Yogui79/IntexPureSpa/Docs/Image/1.HomeAssistant-OFF_Screenshot.jpg

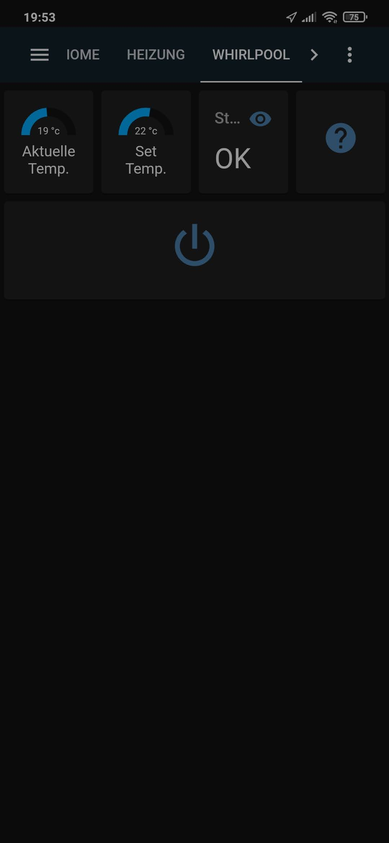
Docs/Image/1.HomeAssistant-OFF_Screenshot.jpg
