Yogui79/IntexPureSpa/Docs/Image/2.HomeAssistant-ON_Screenshot.jpg

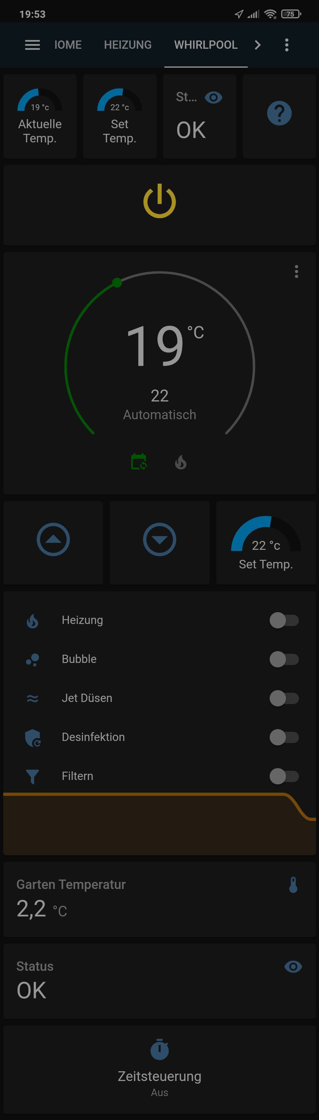
Docs/Image/2.HomeAssistant-ON_Screenshot.jpg
