Yogui79/IntexPureSpa/Docs/Image/3.HomeAssistant-Help-Infos_Screenshot.jpg

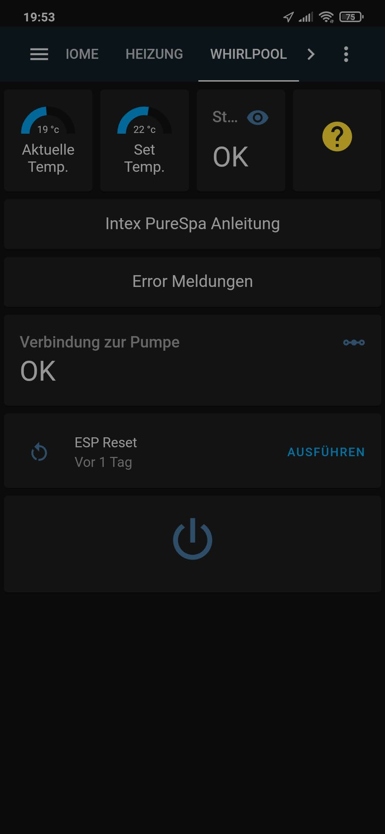
Docs/Image/3.HomeAssistant-Help-Infos_Screenshot.jpg
