Yogui79/IntexPureSpa/Docs/Image/4.HomeAssistant-Timer_Screenshot.jpg

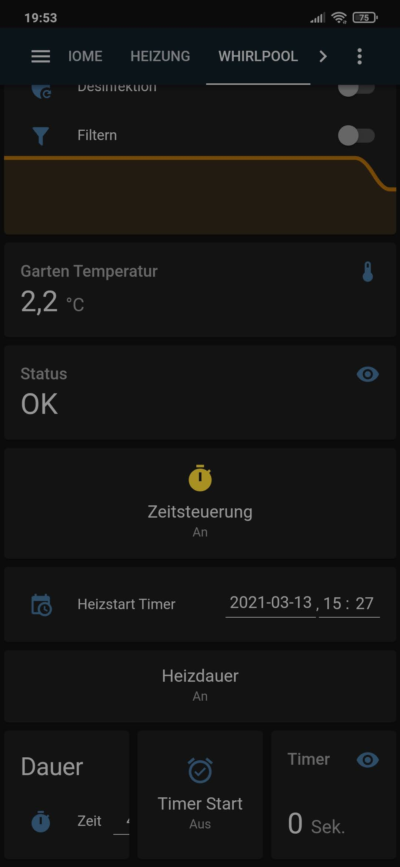
Docs/Image/4.HomeAssistant-Timer_Screenshot.jpg
