Yogui79/IntexPureSpa/Docs/Image/5.HomeAssistant-Push-notification_Screenshot.jpg

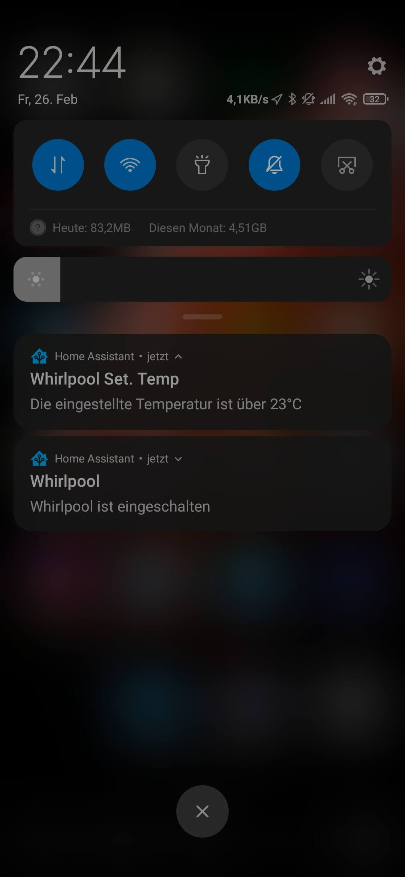
Docs/Image/5.HomeAssistant-Push-notification_Screenshot.jpg
