Yogui79/IntexPureSpa/Docs/Image/10.Jeedom-Dashboard.png

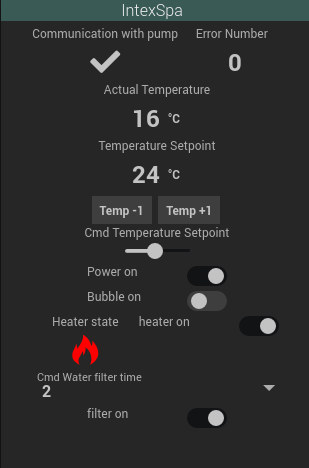
Docs/Image/10.Jeedom-Dashboard.png
