Yogui79/IntexPureSpa/Docs/Image/Board-Screenshot-IDE.PNG

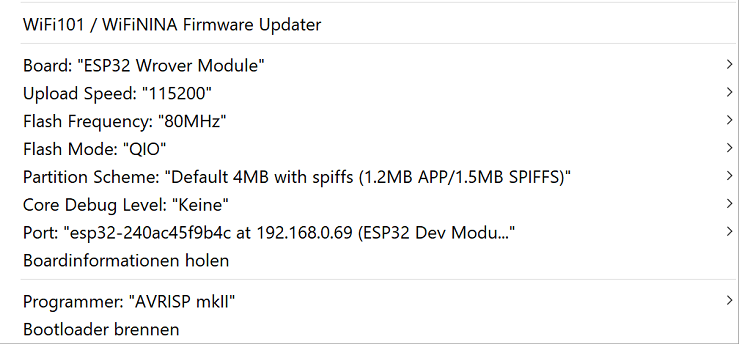
Docs/Image/Board-Screenshot-IDE.PNG
