Yogui79/IntexPureSpa/Docs/Image/Box_LC12s-ESP32_2-small.jpg

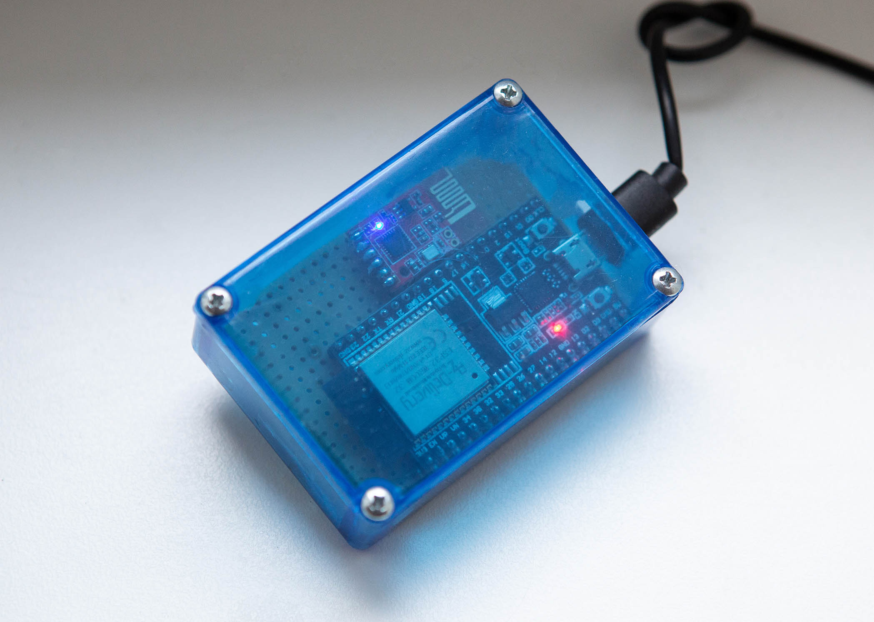
Docs/Image/Box_LC12s-ESP32_2-small.jpg
