Yogui79/IntexPureSpa/Docs/Image/Screenshot-OTA.PNG

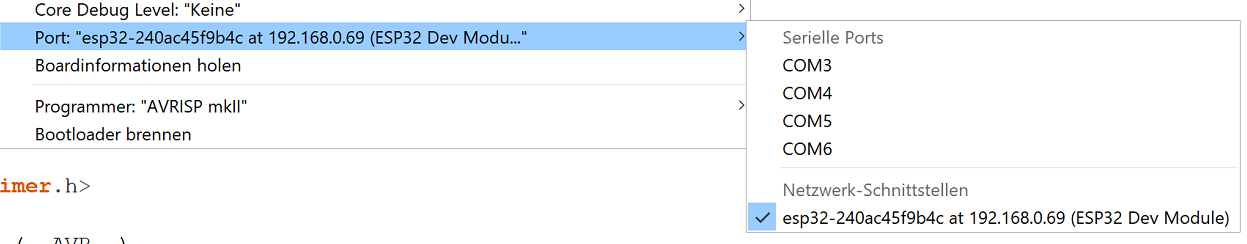
Docs/Image/Screenshot-OTA.PNG
