Yogui79/IntexPureSpa/(threads)

Thread 2 (2021-05-20):

BLE channel scanning not working

Spuri2000, 2021-05-20:
Hi
I tried to search BLE channels many times, but i cant find! The blue led always blinking.
Could you help me?

Yogui79, 2021-05-21:
Hi,
is not BLE ;)
-could you please send me the output arduino serial monitor.
- please also check the wiring be particulay attentive to the pin RX and TX pins. the pin RX from the LC12 goes on TX on the ESP an the TX from the LC12 goes on the RX from the ESP

Thread 17 (2021-07-12):

SearchNetworkID detection time

fgsam1234, 2021-07-12:
### Discussed in https://github.com/Yogui79/IntexPureSpa/discussions/16

<div type='discussions-op-text'>

<sup>Originally posted by **fgsam1234** July  9, 2021</sup>

Hi everyone,

i am running the SearchNetworkID scetch for 7 days and still have no hit. Could there be an issue or can this take so long?
I remember typically 36 hours being mentioned, which is reasonable if you consider 17^4 options for the NetworkID and 1 second per test.
It is a  28462 PureSpa.
The channel has been successfully detected with the fast blinking LED (0x4B). With commented //#define SEARCH_NETWORK_ID the LC12 LED is continuously blinking fast.
When the SearchNetworkID scetch is running with uncommented #define SEARCH_NETWORK_ID, Putty is displaying each second a new line like the one below:

Config AA 5A B9 46 07 94 00 03 00 04 00 4B 00 00 00 12 00 02
AA 5B 9F 70 07 94 00 03 00 04 00 4B 00 00 00 12 00 13

Is this normal and i have to wait for some additional days, or could something be going wrong.

@Yogui79 or @LEECHER1 could you please help me?

Kind regards,
fgsam1234

PS: A strange thing i have noticed is that the ID should be the block 5 and 6 of the hex code - i guess. - but the sketch has already send all codes from 0000 to FFFF and is now continuing from the start once again, just now the block 18 is different then before.</div>

Yogui79, 2021-07-12:
Hello

First of all you don't need to post 2 time the same post
Second as mentioned this code is delivered without warranty
I normally I answered quickly but I do it in my free time and actually I haven't free time to analyse your problem

The log you provide looks good and for me you should find the network id
As you see the code only increase the network id and wait until the spa answered if not he increase again.

Could you try the next channel or the channel before.
Please provide a complete log file.

fgsam1234, 2021-07-13:
Dear Yogui79,

Thank you for analyzing my issue. I have attached the putty log to this post.
Could you please delete the post under discussions. I just used the the button "generate issue from this post" unfortunately it just copied it to Issues and did not delete the initial post in discussions.

I have checked the neighbor channels with the  SearchNetworkID sketch with commented //#define SEARCH_NETWORK_ID. 0x4A does not produce any fast flashing of the LC12 LED. 0x4C produces a fast flashing LED, if i am close to the pump. If I am more then 2 meters away from the pump, it does not flash fast anymore.

I will now try 0x4C, just to be sure.

[putty.log](https://github.com/Yogui79/IntexPureSpa/files/6807056/putty.log)

Yogui79, 2021-07-15:
ok it means 0x4B is the right chanel
please be so close as possible from the pump for searching the network id. the remote control should also be on the pump because in this case the pump sent more that 5 signal/sec if you remove the control from the pump it send only 1/sec

fgsam1234, 2021-07-15:
Ah thanks, that is a good hint. I had the remote detatched.
The LC12 is about 0.3 meters away from the pump. So the distance should be OK.
I will try again with Channel 0x4B and the remote lying on the charging slot of the pump.

fgsam1234, 2021-07-17:
Just for my understanding:
The SearchNetworkID is trying all networkIDs from 0000 to FFFF. It is calculating the checksum from each, sends it and is waiting 1 second for the pump to answer correctly. If not positive, it tries the next.
So if block 5 an 6 of the checksum have reached FF FF all possible combinations gave been tested, correct?

Does it make sense to continue the sketch once FFFF had been reached and no networkID has been found?

fgsam1234, 2021-07-17:
Unfortunately the networkID sketch has reached FFFF for block 5 and 6.
It is still continuing to test IDs. It is currently once again at 0445.
Is it senseful to let it continue? or should I stop it and try something different? If yes, what could I try.

fgsam1234, 2021-07-19:
I was finally able to detect the correct Channel and Network ID. :-)

For that I have changed the delay in the Channelsearch sketch to 3000ms and in the networkID for sketchLastTimeReciveData to 1500ms. By that the Channel could be clearly identified and I had a hit with the networkID within roughly 8 hours.

It works now very well.

Thank you @Yogui79 for the code itself and your support.

MathieuJouslin, 2022-07-03:
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

Hello, where did you changed the delay, in the loop function or in the SetSettingsChannel function ?

Closed 2021-07-20.

Thread 18 (2021-07-19):

Question: ESP32 enclosure

w00dst0ck, 2021-07-19:
Question: Do you have a recommendation for an ESP32 enclosure?
Frage: Habt Ihr eine Empfehlung für ein ESP32 Gehäuse?

BTW: Cooles Projekt!

LEECHER1, 2021-07-19:
I bought this case from Conrad Austria.  I think it's pretty good approx. 4 €
The USB hole is selfmade. ;)

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

w00dst0ck, 2021-07-20:
Thank you for the fast reply

Closed 2021-07-20.

Thread 26 (2021-07-30):

Can't find channel

EricVdB, 2021-07-30:
Hi,

first of all this looks really awesome, it would finally allow me to integrate the SPA into our home automation using OpenHab.

But I can't get the channel search to work. It keeps on blinking steady and never blinks fast. I tried close to the SPA pump (like 5cm away), 1 meter further away, no joy.

If I understood the code well, the fast blinking should happen after you set the channel and the led goes back off, right? (DO_SET = LOW at line 134 in SearchChannel.ino)

Is there anything else i can try?

Model of the SPA = 28442 (bought in belgium)

Kind regards,
Eric

djgel, 2021-07-30:
Hi,  other  user got  a  same  problem. https://github.com/Yogui79/IntexPureSpa/discussions/7

Another   question : Using  a  ESP32 V4  dev model ?

"If I understood the code well, the fast blinking should happen after you set the channel and the led goes back off, right? (DO_SET = LOW at line 134 in SearchChannel.ino)" No, Light turn ON in setting  channel and  turn OFF because  not  rceived data.

Try use correct  board and  review  conections!

EricVdB, 2021-08-02:
Don't have a v4 board available, so I tried with a Arduino, still same result, the fast blinking never happens.
I attached my scope on the solderings and connections are good. I can decode the HEX on the serial line.

Any other ideas?

Yogui79, 2021-08-17:
hello @EricVdB
please post the serial connection logger

bendiger, 2022-04-13:
I have the same issue, I have a hot tub thats not one of the confirmed models thought. All other hardware is the same as whats listed. I have model 28441E the 6 person. I have run through the channel search about 10 times, at varying distance from the pump and from the controller. Still no fast blinks. Not sure what I'm missing, I really hope I don't have a newer model that isn't compatible with this...

bendiger, 2022-04-13:
Shoot.... so I guess my version is the 2021 model. Any hope of getting that one to work with this? Is there anything I can do to help? I do that two of them because of an RMA.

LEECHER1, 2022-04-13:
@bendig
It is easy to check the Spa version. See the screenshot.
Do you have 2021. Is WiFi default than can you use the INTEX APP.

[ https://ibb.co/LZPTPRZ](https://ibb.co/LZPTPRZ)
(Version 2020)

https://ibb.co/b6kX9Sk
(Version 2021 - with WIFI symbol in the left corner)

We haven't tried to works with the 2021, I think it's possible.

Please see how @djgel already posted that the ESP is the v4 developer version.

bertdeelman, 2022-06-09:
Hi,

I can't also retrieve the Channel and I have a 2021 model Spa. Any ideas how the solve this? And is there a way to easy check if I have the right board?

Regards,
Bert

PLCHome, 2023-03-04:
I also have a model from 2021. Before that I had the old one without WiFi. I couldn't find the channel either. However, I noticed that the small blue LED behind the display flashed faster in the old pool. I pressed the lock button to search for a channel. Then you can see the blue LED flashing behind the display. Then the LC12 also flashed at 0x2b.

Thread 38 (2021-10-31):

Home assistant: MQTT Mosquito LOG =>Look like channel change since last boot

egenu, 2021-10-31:
I followed the procedure to find the channel ID and then the Network ID, in my case 0x4C and 0xFFF
I am Fighting to setup my IntexPureSpa, control, with Home assistant: MQTT Mosquito.
I found in my MQTT logs very strange messages:
1635709111: New connection from 192.168.1.144 on port 1883.
1635709111: New client connected from 192.168.1.144 as IntexSpa (p2, c1, k15).
1635709128: New connection from 172.30.32.2 on port 1883.
1635709128: Socket error on client <unknown>, disconnecting.
1635709154: Client IntexSpa has exceeded timeout, disconnecting.
1635709248: New connection from 172.30.32.2 on port 1883.
1635709248: Socket error on client <unknown>, disconnecting.
	a
Could someone give me a hint to search in the right direction?

Yogui79, 2021-11-21:
@LEECHER1  as you use Home Assistna could you help ?

but looks like the IP dresse is wrong configurated

LEECHER1, 2021-11-21:
@egenu
Hey,

It looks the ESP32 has a bad Network (Wifi) connection.

Is the IP 192.168.1.144 the ESP32?
Please, fix the IP on the router of the ESP as static IP.

Check the WIFI Siginal with this code:
https://learn.adafruit.com/adafruit-metro-esp32-s2/wifi-test

Do you see on this link what dBM values say:
https://eyenetworks.no/en/wifi-signal-strength/

br LEECHER1

egenu, 2021-11-25:
Hi  LEECHER1 and Yogui79,

First of all I would like to say that I am amazed about the work that you have done and you have all my respect for such work!

The IP 192.168.1.144 is the ESP32, I fixed it as static IP on the router, thanks for your suggestion.
I made the Wifi test and I got a -48 dBm signal, then I believe this is not the issue.

On the other hand I retry the full procedure many times and the Channel ID has change 3x during my successive attempt , is this normal?

The last attempt that I made after applying your suggestions give me a 0x9C channel who is the first time and the Network ID program is not scanning anymore like it was the first times I launched, maybe due to Arduino updates that I had to apply?

Could someone please confirm that the SearchNetworkId.ino program is still working with latest Arduino program and library updates?

Thanks again for sharing and giving all that work to the comunity!
Egenu

Yogui79, 2021-11-26:
hello

_"On the other hand I retry the full procedure many times and the Channel ID has change 3x during my successive attempt , is this normal?_"

-> yes it's possible

please give me version you use for :+1:
Arduino ide you use
the esp32 lib you use

egenu, 2021-11-27:
Hello

Actually I have installed Arduino IDE    1.8.16
and  I use esp32 by Expressif Systems   1.0.6
EspMQTTClient              1.13.2
arduino-timer                2.3.0
ArduinoOTA                    1.0.7

Hope this was you where looking for.

Yogui79, 2021-11-27:
I haven't test with arduino ide 1.8.16 but should work
 esp32 by Expressif Systems 1.0.6 I use alsa this one.

the SearchNetworkId.ino  sketch is only to detect the network id from the LC12s from the pump and the first preoblem you speek about was a mqtt pissue.

please could you be more clear :
1 do you find the chanel ?
2 download the sketch  SearchNetworkId.ino and modifie the line uint8_t Channel =0x47; with your chanel
3 post a video from your LC12s after that

egenu, 2021-11-27:
Hello, sorry to add more confusion than wanted. Due to the fact that I didn't understood, if my issue was coming from the fact that the source of my unsuccessful attempt was coming from the :
MQTT <=> Home assistant or SPA <=> Board with the channel ID and then the Network ID found a
Then I retry many times the full operation and this is why I was surprised to see a different chanel.

To answer to your questions
1) do you find the chanel ?
-> Yes 9B & 9C
2) Edited the line uint8_t Channel =0x9B ;and download it
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

3) -> https://user-images.githubusercontent.com/73351718/143678705-afa00b44-c4f3-4772-9b33-0106038f859d.MOV

Yogui79, 2021-11-27:
look's good
now remove the // from this line #define SEARCH_NETWORK_ID
upload the sketch
start monitoring the ouput with puty and save the data in a file the search network id  can last up to 36 hours you will ahve a message when the network id is found

egenu, 2021-11-28:
Hi,

Look like my previous NETWORK_ID didn't success, even if I had a similar message at the end.
----------------------------
  Your network id is:
         0x153F
----------------------------
Then I put the "used_chanel" (0x9B) and "used_network" (0x153F) on my "PureSpa Sofware" with the MQTT and WIFI settings
and sudainly works like a charm.

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

Many thanks to both.

egenu, 2021-11-28:
Still an issue :(
after removing the PC and using a wall mount plug the board is blinking like before, but I am unable to get control / communication with Homeassistant, but the fixe IP on the board is answering his the IP 192.168.1.144 (ping)
what did I do wrong!
Cheers

LEECHER1, 2021-11-28:
Is the communication with ESP32 to Pump and Controller okay?
Maybe the channel has changed. Is possible from time to time. Wait a little bit ~10min

Or is only the communication with ESP32 to Home Assistant not okay?

egenu, 2021-11-28:
I have trouble to understand, how to diagnose the communication with ESP32 to Pump and Controller? Is only with the blinking led that you are able know? How to access the serial communication when the ESP32 is not anymore USB connected to my PC, with OTA Arduino IDE complains that the:
 "Serial Monitor is not supported on network ports such as 192.168.1.144 for the ESP32 Dev Module i this release"

From the Home Assistant Mosquito MQTT broker log I believe it works:
I see the following, and I assume this parts works, but as it do not update he is in TIMEOUT situation:

1638114518: New connection from 192.168.1.144 on port 1883.
1638114518: New client connected from 192.168.1.144 as IntexSpa (p2, c1, k15).
...
1638114978: Client IntexSpa has exceeded timeout, disconnecting.

Yogui79, 2021-11-30:
` have trouble to understand, how to diagnose the communication with ESP32 to Pump and Controller? Is only with the blinking led that you are able know? ` yes only over the blinking from the blue led it should be very fast
yo have no way to diagnose over ota

egenu, 2021-12-04:
Hello good news,

I had to reset completely my SPA. the controller "tablet" discharging it completely .
I left the SPA without power for 24 hours to.
After this "RESET", I just try the connectivity using a wall mount plug for the ESP32 board.
He is blinking like before, and everything start working inside home assistant after 10 minutes like you said!
Inside the MQTT logs I saw the INTEXSPA connectivity and doesn't timeout anymore.
A big thanks to both and if you have an By me a Beer or something else I would be happy to contribute.

Closed 2021-12-04.

Thread 39 (2021-11-18):

Spa Programm not working

HansEhls, 2021-11-18:
Hi there,
I have an Intex Pure Spa 28462 whirlpool and am trying to get the GitHub project up and running.

Hardware built wasn't that difficult.
Connected, I also found the channel, then also the network address.

Now I have loaded the spa program and I can't get any further because unfortunately I have no knowledge of programming.

The program logs on to the network and also to the MQTT, then some values   (probably the different statuses) are communicated wildly between the pump and the program. Then it breaks off and looks for a new channel and the whole thing starts over.
I switched on all debugs and downloaded the serial info.

Could someone help me and try to understand what the problem is?

The program also logs on to Mosquitto and sends up 2 types of messages, but none such as temperature or similar.

I also installed Home Assistant in case a handshake was required. These are the CMD messages that you see in the Mosqutitto.

It would be great if someone could help me.

Thanks in advance

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
[Serial Info.odt](https://github.com/Yogui79/IntexPureSpa/files/7565357/Serial.Info.odt)

w00dst0ck, 2021-11-18:
Have you tried to reduce the distance between the Intex and the ESP32. That fixed the problem with the lost channel for me.

HansEhls, 2021-11-18:
Hi,
thanx for the tip, but no change, even when it direct on the pump

LEECHER1, 2021-11-19:
Please try to reset the Pumpe and the distance ~1m and wait 15 min. > Not working try again.

HansEhls, 2021-11-19:
Not working. Same serial protokoll

Yogui79, 2021-11-21:
regarding the log you have distubation during communication between pump and ESP looks like you only communicate with remote control.
-> switch ESP off
->switch pump off (unplug)
->switch remoter control off
->remove remote control from the pump

-> switch on pump and reset it
-> put remote control on pump
-> be sure you dont have E81
-> switch on ESP

if not working please send a log configurate like this :

//Uncomment following line to have more debug infos
//#define DEBUG_RECIEVED_DATA
#define DEBUG_SEARCH_CHANNEL
#define DEBUG_SEND_COMMAND
#define DEBUG_PUMP_DATA
#define DEBUG_CONTROLLER_DATA
#define DEBUG_CONFIG
//#define DEBUG_MQTT
//#define DEBUG_SEND_VALUE_TO_HOME_AUTOMATION_SW

HansEhls, 2021-11-22:
Hi,

first of all thank you, that you are trying to help. no change and as I removed some debug data, the serial info is smaller now.

20:38:44.711 -> Used first command read from EEPROM 0x4B
20:38:44.711 ->  Config AA 5A B9 46 FF FF 00 00 00 04 00 4B 00 00 00 12 00 62
20:38:51.032 -> Debug Send command : 4B 00 00 00 00 00 A9 B2
20:38:52.629 -> Debug Send command : 4B 00 00 00 00 00 A9 B2
20:38:54.233 -> Debug Send command : 4B 00 00 00 00 00 A9 B2
20:38:55.462 -> Look like channel change since last boot
20:38:55.462 ->  Config AA 5A B9 46 FF FF 00 00 00 04 00 41 00 00 00 12 00 58
20:38:56.955 ->
20:38:56.955 -> Debug search Chanel : AA 5B D6 F5 FF FF 00 00 00 04 00 41 00 00 00 12 00 25  Config AA 5A B9 46 FF FF 00 00 00 04 00 42 00 00 00 12 00 59
20:38:59.432 ->
20:38:59.432 -> Debug search Chanel : AA 5B D6 F5 FF FF 00 00 00 04 00 42 00 00 00 12 00 26  Config AA 5A B9 46 FF FF 00 00 00 04 00 43 00 00 00 12 00 5A

Yogui79, 2021-11-22:
please post the debug data after the esp start
somme important information for me are her mentioned

HansEhls, 2021-11-22:
22:07:02.488 -> Ready
22:07:02.488 -> IP address: 192.168.178.201
22:07:03.579 -> Used Channel read from EEPROM 0x4B
22:07:03.579 -> Used first command read from EEPROM 0x4B
22:07:03.579 ->  Config AA 5A B9 46 FF FF 00 00 00 04 00 4B 00 00 00 12 00 62
22:07:05.078 -> AA IntexSpa/Communication with pump 1
22:07:05.882 -> 5B IntexSpa/Communication with pump 1
22:07:05.916 -> D6 IntexSpa/Communication with pump 1
22:07:05.916 -> F5 IntexSpa/Communication with pump 1
22:07:05.916 -> FF IntexSpa/Communication with pump 1
22:07:05.916 -> FF IntexSpa/Communication with pump 1
22:07:05.916 -> 00 IntexSpa/Communication with pump 1

HansEhls, 2021-11-22:
this comes up, when I reset the buttons on the board

22:48:02.289 -> ets Jun  8 2016 00:22:57
22:48:02.289 ->
22:48:02.289 -> rst:0x1 (POWERON_RESET),boot:0x3 (DOWNLOAD_BOOT(UART0/UART1/SDIO_REI_REO_V2))
22:48:02.289 -> waiting for download
22:48:03.508 -> ets Jun  8 2016 00:22:57
22:48:03.508 ->
22:48:03.508 -> rst:0x1 (POWERON_RESET),boot:0x13 (SPI_FAST_FLASH_BOOT)
22:48:03.508 -> configsip: 0, SPIWP:0xee
22:48:03.545 -> clk_drv:0x00,q_drv:0x00,d_drv:0x00,cs0_drv:0x00,hd_drv:0x00,wp_drv:0x00
22:48:03.545 -> mode:DIO, clock div:1
22:48:03.545 -> load:0x3fff0018,len:4
22:48:03.545 -> load:0x3fff001c,len:1216
22:48:03.545 -> ho 0 tail 12 room 4
22:48:03.545 -> load:0x40078000,len:10944
22:48:03.545 -> load:0x40080400,len:6388
22:48:03.545 -> entry 0x400806b4
22:48:03.789 -> E (64) psram: PSRAM ID read error: 0xffffffff
22:48:03.823 -> ----------------------------------------------------------------------------------------------------------------------
22:48:03.860 ->
22:48:03.860 ->           Intex Purespa communication sketch version 1.1.1 build on : 2021.07.31 21:27:53
22:48:03.860 ->
22:48:03.860 -> ----------------------------------------------------------------------------------------------------------------------
22:48:03.860 -> Booting
22:48:06.167 -> Ready
22:48:06.167 -> IP address: 192.168.178.201
22:48:07.291 -> Used Channel read from EEPROM 0x4B
22:48:07.291 -> Used first command read from EEPROM 0x4B
22:48:07.291 ->  Config AA 5A B9 46 FF FF 00 00 00 04 00 4B 00 00 00 12 00 62
22:48:13.661 -> Debug Send command : 4B 00 00 00 00 00 A9 B2
22:48:15.657 -> Debug Send command : 4B 00 00 00 00 00 A9 B2
22:48:19.305 -> Debug Send command : 4B 00 00 00 00 00 A9 B2
22:48:19.305 -> Look like channel change since last boot
22:48:19.305 ->  Config AA 5A B9 46 FF FF 00 00 00 04 00 41 00 00 00 12 00 58
22:48:20.813 -> 03 FF 00

HansEhls, 2021-11-22:
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
I do not know, if that is important, but in the edge down, right, there is a blue LED which is blinking fast all the time. I have no idea, if that is normal

Yogui79, 2021-11-24:
this is norma this is the conection between pum an remote control
how long did you wait after starting your ESP

HansEhls, 2021-11-24:
in the meanwhile several times over 30 min.

Yogui79, 2021-11-26:
could you poste your project ?

HansEhls, 2021-11-27:
I copied the Spa programm and did only these changes!

#define USED_NETWORK_ID    0xFFFF
#define USED_CHANNEL       **0x4B**

uncomment "//" #define _28458_28462_   // For spa model #28458 #28462 #28457(US) #28461(US)
//#define _28442_28440_   // For spa Model #28442 #28440

#if  defined (_28458_28462_) &&  defined (_28442_28440_)
  #error select only one SPA model
#endif
#if  !defined (_28458_28462_) &&  !defined (_28442_28440_)
  #error select a SPA model
#endif

/*******************************************************
*
*   S E L E C T  T H E   P R O T O C O L   Y O U   U S E
*
********************************************************/
//#define _MY_SENSORS_
#define _MQTT_

#ifdef ESP32
const char* Myssid = **"My Wlan"**;
const char* Mypassword = **"My Pass"**;
#endif

EspMQTTClient client(
  Myssid,
  Mypassword,
  "192.168.178.97",  // MQTT Broker server ip
  **"Iobroker"**,   // Can be omitted if not needed
  **"Password",**   // Can be omitted if not needed
  "IntexSpa",     // Client name that uniquely identify your device
  1883              // The MQTT port, default to 1883. this line can be omitted
);
#endif

Yogui79, 2021-11-27:
coul you olease donwload the SearchNetworkId.ino sketch
make following changes

uint8_t Channel =0x4B;
#define SEARCH_NETWORK_ID
uint16_t idtosend =0xFFFA;

en postet the serial monitor  after 10 mins

HansEhls, 2021-11-28:
I did a new channel search and found E1. Then I did a new network search and found 0x14f7. With that in the Spa Programm it did connect to the pump and also wrote the data one time into MQTT broker.

BUT:
When the ESP was connecting to the pump the controller went do E81 error. when I put off the ESP the controller searched the pump end reconnected. I did that several time, but had always the same result. I did many resets of the pump to try that again, with the same result. I think after 5 resets the ESP does not find the pump anymore.

So I starting over, reseted the pump, started the controller. After that connection seams now stable, i searched the channel, which is back to 4B. then I started the Nework scan with 0x14F0 so see, if it will find again 0x14F7. That didn´t work. So now I started the network search at 0x0000 again and wait, if it will find another network address.

Did I do something wrong?

THanks for your help. I really appreciate that.

BR
Hans

Yogui79, 2021-11-30:
Hi,
we newer se a networkid  who change but afrer switching off the pump it could be that the chanel change

HansEhls, 2021-12-01:
Update!!!
I had a connection to the controller and the pump with 0xFFFF abd 0x4B again. I played around with some own debugs to understand the programm. As I said, I am completely new to the topic programming.

Then somehow I lost the connection again and had to do a channel and network search again. I found the channel 0xA4 and with that again the netword 0x14F7.

With that, at least for the moment (the pump is in my office at the moment) I have the connection established and the programm is running.

I also have the data in MQTT, so I can start to look for the VIS in Iobroker.

Hopefully the program will work also in the future, when I setup the pool again outside in the next days.

Thanks again for your help and the effort you spend on that!

BR
Hans

Closed 2021-12-01.

Thread 40 (2021-11-19):

Network ID search

delgigio, 2021-11-19:
Good morning,
I have carefully followed the guide you have given me, I have managed to find the channels with which the whirlpool communicates which are 12 and 13.
Unfortunately, when I load the program to search for the Network ID, the blue LED does not flash as indicated, it always has the same frequency as all the other channels.
The detection of the channels has been done over and over again and the result was always channel 12 and 13. I have also tried inserting channels 9 10 11 12 13 14 15 16 but with very bad results.
What can I do?
I hope you can help me... Thank you in advance.

HansEhls, 2021-11-19:
Could you Upload a screenshot of the Programm when you entered the channel

delgigio, 2021-11-21:
This is the channel search program

/*
 * THIS SOFTWARE IS PROVIDED "AS IS" AND
 * ANY EXPRESS OR IMPLIED WARRANTIES, INCLUDING, BUT NOT LIMITED TO, THE IMPLIED
 * WARRANTIES OF MERCHANTABILITY AND FITNESS FOR A PARTICULAR PURPOSE ARE
 * DISCLAIMED. IN NO EVENT SHALL <COPYRIGHT HOLDER> BE LIABLE FOR ANY
 * DIRECT, INDIRECT, INCIDENTAL, SPECIAL, EXEMPLARY, OR CONSEQUENTIAL DAMAGES
 * (INCLUDING, BUT NOT LIMITED TO, PROCUREMENT OF SUBSTITUTE GOODS OR SERVICES;
 * LOSS OF USE, DATA, OR PROFITS; OR BUSINESS INTERRUPTION) HOWEVER CAUSED AND
 * ON ANY THEORY OF LIABILITY, WHETHER IN CONTRACT, STRICT LIABILITY, OR TORT
 * (INCLUDING NEGLIGENCE OR OTHERWISE) ARISING IN ANY WAY OUT OF THE USE OF THIS
 * SOFTWARE, EVEN IF ADVISED OF THE POSSIBILITY OF SUCH DAMAGE.
 *
 *   Pin connection
 *              
 *                       LC12S     Arduino     ESP
 *  ___________________
 * |                  o| GNG       GND         GND
 * |                  o| CS        D5          D18
 * |                  o| SET       D6          D19
 * |                  o| TX        D2          D16
 * |                  o| RX        D4          D17
 * |__________________o| VCC       3.3V        3.3V
*/

uint8_t test= 0x00;

#if defined (__AVR__)
#include <SoftwareSerial.h>
SoftwareSerial mySerial(2, 4); // RX, TX
// Output defines
#define DO_SET    6
#define DO_CS     5
#elif defined (ESP32)
#define mySerial   Serial2
#define DO_SET    19
#define DO_CS     18
#endif

void setup() {
  mySerial.begin(9600);
  Serial.begin(115200);

  pinMode(DO_SET, OUTPUT);        // SET
  pinMode(DO_CS, OUTPUT);        // CS - можно просто соединить с GND
  delay(1000);

  digitalWrite(DO_CS, LOW);     // притягиваем к массе
  digitalWrite(DO_SET, LOW);
  delay(100);

 // querryversion();

}

void loop() {

  SetSettingsChannel(test++);
  Serial.print("Channel ");
  Serial.println(test-1, HEX);
  delay(1000);
}

void SetSettingsChannel(uint8_t channelid){
  byte Config[20];
  char res[5];

  Config[1]=0xAA;
  Config[2]=0x5A;

  //device ID
  Config[3]=0xB9;
  Config[4]=0x46;

//Network ID
  Config[5]=0x00;
  Config[6]=0X00;

  Config[7]=0x00;

  //RF Power
  Config[8]=0x03;

  Config[9]=0x00;

  // Baudrate
  Config[10]=0x04;

  Config[11]=0x00;
  //channel
  Config[12]=channelid;

  Config[13]=0x00;
  Config[14]=0x00;
  Config[15]=0x00;
  Config[16]=0x12;
  Config[17]=0x00;
  //reset checksum
  Config[18] =0x0;

  //calculate Checsum
  for(int i=1;i<17;i++){

    Config[18] =Config[18] +Config[i];
  }
/*
  Serial.print (F(" Config "));
  for(int i=1;i<19;i++){
    sprintf(&res[0],"%02X",Config[i]);
    Serial.print(res);
    Serial.print(F(" "));
  }
  Serial.println (F(""));
*/
  digitalWrite(DO_SET, LOW);
  delay(500);

  for(int i=1;i<19;i++){

    mySerial.write(Config[i]);
  }
 delay(1000);

 digitalWrite(DO_SET, HIGH);

}

void querryversion(){
  byte Config[20];
  char res[5];

  //byte checksum;
  Config[1]=0xAA;
  Config[2]=0x5D;
  Config[3]=0x00;
  Config[4]=0x00;
  Config[5]=0x00;
  Config[6]=0x00;
  Config[7]=0x00;
  Config[8]=0x00;
  Config[9]=0x00;
  Config[10]=0x00;
  Config[11]=0x00;
  Config[12]=0x00;
  Config[13]=0x00;
  Config[14]=0x00;
  Config[15]=0x00;
  Config[16]=0x00;
  Config[17]=0x00;
  Config[18] =0x07;

  Serial.print (F("Querry version "));
  for(int i=1;i<19;i++){
    sprintf(&res[0],"%02X",Config[i]);
    Serial.print(res);
    Serial.print(" ");
  }

  Serial.println (F(""));
  digitalWrite(DO_SET, LOW);
  delay(500);

  for(int i=1;i<19;i++){

    mySerial.write(Config[i]);
  }
 delay(1000);
 digitalWrite(DO_SET, HIGH);
}

This is the programme for searching the network ID once the channels have been found.

/*
  * THIS SOFTWARE IS PROVIDED "AS IS" AND
 * ANY EXPRESS OR IMPLIED WARRANTIES, INCLUDING, BUT NOT LIMITED TO, THE IMPLIED
 * WARRANTIES OF MERCHANTABILITY AND FITNESS FOR A PARTICULAR PURPOSE ARE
 * DISCLAIMED. IN NO EVENT SHALL <COPYRIGHT HOLDER> BE LIABLE FOR ANY
 * DIRECT, INDIRECT, INCIDENTAL, SPECIAL, EXEMPLARY, OR CONSEQUENTIAL DAMAGES
 * (INCLUDING, BUT NOT LIMITED TO, PROCUREMENT OF SUBSTITUTE GOODS OR SERVICES;
 * LOSS OF USE, DATA, OR PROFITS; OR BUSINESS INTERRUPTION) HOWEVER CAUSED AND
 * ON ANY THEORY OF LIABILITY, WHETHER IN CONTRACT, STRICT LIABILITY, OR TORT
 * (INCLUDING NEGLIGENCE OR OTHERWISE) ARISING IN ANY WAY OUT OF THE USE OF THIS
 * SOFTWARE, EVEN IF ADVISED OF THE POSSIBILITY OF SUCH DAMAGE.
 *              
 *              
 *              
 *                       LC12S     Arduino     ESP
 *  ___________________
 * |                  o| GNG       GND         GND
 * |                  o| CS        D5          D18
 * |                  o| SET       D6          D19
 * |                  o| TX        D2          D16
 * |                  o| RX        D4          D17
 * |__________________o| VCC       3.3V        3.3V
*/

uint8_t Channel =0x13;
#define SEARCH_NETWORK_ID
uint16_t idtosend =0x0000;

#if defined (__AVR__)
#include <SoftwareSerial.h>
// Output defines
SoftwareSerial mySerial(2, 4); // RX, TX
// Output defines
#define DO_SET    6
#define DO_CS     5
#elif defined (ESP32)
#define mySerial   Serial2
#define DO_SET    19
#define DO_CS     18
#endif

unsigned long LastTimeReciveData;
uint16_t SearchNetworkIdDataCount;
bool datareceived;
bool NetworkIdOk;

void setup() {
  mySerial.begin(9600);
  Serial.begin(115200);
  pinMode(DO_SET, OUTPUT);        // SET
  pinMode(DO_CS, OUTPUT);        // CS
  delay(1000);

  digitalWrite(DO_CS, LOW);
  digitalWrite(DO_SET, LOW);
  Serial.println(F(""));
  Serial.println(F("-----------------------------------------------------------"));
  Serial.println(F(""));
#ifdef SEARCH_NETWORK_ID
  Serial.println (F("          Search Network id active"));
#else
  Serial.println (F("          Check Channel"));
  Serial.println (F(""));
  Serial.println (F("          LED on LC12s should blink fast"));
#endif
  Serial.println(F(""));
  Serial.println(F("-----------------------------------------------------------"));

  ChangeSettings(idtosend++);

  //querryversion();
}

void loop() {
char res[5];
 #ifdef __AVR__
   mySerial.listen();
   if ( mySerial.overflow() )
   {
        Serial.println("overflow");
        while ( mySerial.available() )
          mySerial.read();
   }
   else
#endif
   {
     if (mySerial.available())
     {
        uint8_t c =mySerial.read();

      if (!NetworkIdOk){
        sprintf(&res[0],"%02X",c);
        Serial.write(res);
        Serial.print(" ");
        datareceived = true;
        SearchNetworkIdDataCount++;
      }
     if (SearchNetworkIdDataCount >1500 && !NetworkIdOk){
        NetworkIdOk = true;
        uint16_t YourNetworkId = idtosend-1;
        sprintf(&res[0],"%02X",YourNetworkId);
        Serial.println (F(""));
        Serial.println (F("-----------------------------------------------------------"));
        Serial.println (F(""));
        Serial.println (F("          Your network id is :"));
        Serial.println (F(""));
        Serial.print (F("                 0x"));
        Serial.write(res);
        Serial.println (F(""));
        Serial.println (F(""));
        Serial.println (F("-----------------------------------------------------------"));
     }
      LastTimeReciveData =millis();
     }
   }

#ifdef SEARCH_NETWORK_ID
   if ((millis()-LastTimeReciveData  > 1000 ) && datareceived ){
      Serial.println("");
      datareceived = false;
      SearchNetworkIdDataCount = 0;
      ChangeSettings(idtosend++);
   }

   if (millis()-LastTimeReciveData  > 120000 ){
       Serial.println("");
       Serial.println("Timeout");
      SearchNetworkIdDataCount = 0;
      datareceived = false;
      ChangeSettings(idtosend++);
   }
  #endif

}

void ChangeSettings(uint16_t id){
  byte Config[20];
  char res[5];

  //byte checksum;
  Config[1]=0xAA;
  Config[2]=0x5A;
  Config[3]=0xB9;
  Config[4]=0x46;
  Config[5]=id>>8;
  Config[6]=id;
  Config[7]=0x00;
  Config[8]=0x03;
  Config[9]=0x00;
  Config[10]=0x04;
  Config[11]=0x00;
  Config[12]=Channel;
  Config[13]=0x00;
  Config[14]=0x00;
  Config[15]=0x00;
  Config[16]=0x12;
  Config[17]=0x00;
  Config[18] =0x0;

  //calculate Checksum
  for(int i=1;i<17;i++){
    Config[18] =Config[18] +Config[i];
  }

  Serial.println (F(""));           
  Serial.print (F("Config "));
  for(int i=1;i<19;i++){
    sprintf(&res[0],"%02X",Config[i]);
    Serial.print(res);
    Serial.print(F(" "));
  }
  Serial.println (F(""));            

  digitalWrite(DO_SET, LOW);
  delay(500);

  for(int i=1;i<19;i++){

    mySerial.write(Config[i]);
  }
 delay(1000);
 digitalWrite(DO_SET, HIGH);

}

void querryversion(){
  byte Config[20];
  char res[5];

  //byte checksum;
  Config[1]=0xAA;
  Config[2]=0x5D;
  Config[3]=0x00;
  Config[4]=0x00;
  Config[5]=0x00;
  Config[6]=0x00;
  Config[7]=0x00;
  Config[8]=0x00;
  Config[9]=0x00;
  Config[10]=0x00;
  Config[11]=0x00;
  Config[12]=0x00;
  Config[13]=0x00;
  Config[14]=0x00;
  Config[15]=0x00;
  Config[16]=0x00;
  Config[17]=0x00;
  Config[18] =0x07;

  Serial.print (F("Querry version "));
  for(int i=1;i<19;i++){
    sprintf(&res[0],"%02X",Config[i]);
    Serial.print(res);
    Serial.print(" ");
  }

  Serial.println (F(""));
  digitalWrite(DO_SET, LOW);
  delay(500);

  for(int i=1;i<19;i++){

    mySerial.write(Config[i]);
  }
 delay(1000);
 digitalWrite(DO_SET, HIGH);

}

Yogui79, 2021-11-21:
Hello,

1. could you please say me whats append if you comment this line
`//#define SEARCH_NETWORK_ID`

2.Enable again this line
`#define SEARCH_NETWORK_ID`

3. Use putty an log the serial communication, as mentioned in the description, at lease 36h
4. Poste the logged file

delgigio, 2021-11-21:
Evening,
point one I did not understand what you mean.
For point two should I add the two bars? // or what should I write?
Point three the Putty I haven't used yet since the led light doesn't have the correct frequency.

Thanks for helping me

Yogui79, 2021-11-21:
for point 1 make a video please from the LC12S with the right chanel

for point 2 write #define SEARCH_NETWORK_ID  on line 28 from the SearchNetworkId.ino

Yogui79, 2021-11-21:
otther remarke you need to be close to your pump
pump and display should be on without error E81

delgigio, 2021-11-22:
To do the signal detection I was close to about 50 centimetres with the display on without any error.
In the program loaded on ESP32 I had written as you indicated (#define SEARCH_NETWORK_ID).
Thank you

Thread 44 (2022-03-05):

configuration.yaml does not parse properly for HomeAssistant

TaosEnergy, 2022-03-05:
From line 149 down (#Template Sensor) the file does not validate/ does not parse properly.  There is some sort of syntax issue(s).  I used codebeautify.org/yaml-validator

LEECHER1, 2022-03-06:
Hey,

Thx i will check it, but the YAML files is only an example.

LEECHER1, 2022-07-02:
Thanks :)

what has changed?

guevara777 ***@***.***> schrieb am Fr., 1. Juli 2022, 12:34:

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

guevara777, 2022-07-04:
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

That has changed ;) -> https://www.home-assistant.io/blog/2022/06/01/release-20226/ -> See "Breaking Changes"

madhehler, 2023-04-28:
Hello
I am really struggling to integrate the ESP into my HA
Can you please help me, I really getting crazy

Greetinsg
Mat

madhehler, 2023-04-30:
Hello

can you please provide me the whole configuration then, I am really lost

rommess, 2023-06-13:
Hi guys, i'de like to share my "code" in the new format, as i seen many poeple having trouble. based on @guevara777 code.
work for me so far.
@Portos1327

`
mqtt:

  # Intex Pool ESP-Restart Button
  button:
  - unique_id: intex_pool_restart
    device:
      identifiers:
        - "Intex Spa"
      manufacturer: "Intex"
      model: "SPA"
      name: "Intex Spa Pool"
    command_topic: IntexSpa/Cmd Reset ESP
    payload_press: "reset"
    name: "Intex Pool Restart"
    entity_category: "config"
    device_class: "restart"

  # Intex Pool Decrease SetTemp Button
  - unique_id: intex_pool_decrease
    device:
      identifiers:
        - "Intex Spa"
      manufacturer: "Intex"
      model: "SPA"
      name: "Intex Spa Pool"
    command_topic: IntexSpa/Cmd decrease
    payload_press: "1"
    name: "Intex Pool Set Temp Decrease"

  # Intex Pool Increase SetTemp Button
  - unique_id: intex_pool_increase
    device:
      identifiers:
        - "Intex Spa"
      manufacturer: "Intex"
      model: "SPA"
      name: "Intex Spa Pool"
    command_topic: IntexSpa/Cmd increase
    payload_press: "1"
    name: "Intex Pool Set Temp Increase"

  # Select
  select:

  # Intex Pool Filter Time Input Select
  - unique_id: intex_pool_filter_setup_time_select
    device:
      identifiers:
        - "Intex Spa"
      manufacturer: "Intex"
      model: "SPA"
      name: "Intex Spa Pool"
    command_topic: IntexSpa/Cmd water filter time
    state_topic: IntexSpa/filter setup time
    name: "Intex Pool Filter Setup Time Select"
    options:
#      - "0"
      - "2"
      - "4"
      - "6"

  # Intex Pool Sanitizer Time Input Select
  - unique_id: intex_pool_sanitizer_setup_time_select
    device:
        identifiers:
          - "Intex Spa"
        manufacturer: "Intex"
        model: "SPA"
        name: "Intex Spa Pool"
    command_topic: IntexSpa/Cmd Sanitizer time
    state_topic: IntexSpa/Sanitizer setup time
    name: "Intex Pool Sanitizer Setup Time Select"
    options:
#        - "0"
        - "3"
        - "5"
        - "8"

  # MQTT Pool Schalter
  switch:

  - unique_id: intex_pool_power_switch
    device:
      identifiers:
        - "Intex Spa"
      manufacturer: "Intex"
      model: "SPA"
      name: "Intex Spa Pool"
    command_topic: IntexSpa/Cmd Power on off
    state_topic: IntexSpa/Power on
    payload_on: "1"
    payload_off: "0"
    name: "Intex Pool Power"

  - unique_id: intex_pool_filter_switch
    device:
      identifiers:
        - "Intex Spa"
      manufacturer: "Intex"
      model: "SPA"
      name: "Intex Spa Pool"
    command_topic: IntexSpa/Cmd water filter on off
    state_topic: IntexSpa/filter on
    payload_on: "1"
    payload_off: "0"
    name: "Intex Pool Filter"

  - unique_id: intex_pool_bubble_switch
    device:
      identifiers:
        - "Intex Spa"
      manufacturer: "Intex"
      model: "SPA"
      name: "Intex Spa Pool"
    command_topic: IntexSpa/Cmd bubble on off
    state_topic: IntexSpa/Bubble on
    payload_on: "1"
    payload_off: "0"
    name: "Intex Pool Bubble"

  - unique_id: intex_pool_heater_switch
    device:
      identifiers:
        - "Intex Spa"
      manufacturer: "Intex"
      model: "SPA"
      name: "Intex Spa Pool"
    command_topic: IntexSpa/Cmd heater on off
    state_topic: IntexSpa/heater on
    payload_on: "1"
    payload_off: "0"
    name: "Intex Pool Heat"

  - unique_id: intex_pool_water_jet_switch
    device:
      identifiers:
        - "Intex Spa"
      manufacturer: "Intex"
      model: "SPA"
      name: "Intex Spa Pool"
    command_topic: IntexSpa/Cmd water jet on off
    state_topic: IntexSpa/Water jet on
    payload_on: "1"
    payload_off: "0"
    name: "Intex Pool Water Jet"

  - unique_id: intex_pool_sanitizer_switch
    device:
      identifiers:
        - "Intex Spa"
      manufacturer: "Intex"
      model: "SPA"
      name: "Intex Spa Pool"
    command_topic: IntexSpa/Cmd sanitizer on off
    state_topic: IntexSpa/Sanitizer on
    payload_on: "1"
    payload_off: "0"
    name: "Intex Pool Sanitizer"

  # MQTT Pool Sensoren
  sensor:
  - unique_id: intex_pool_status
    device:
      identifiers:
        - "Intex Spa"
      manufacturer: "Intex"
      model: "SPA"
      name: "Intex Spa Pool"
    name: "Intex Pool Status"
    state_topic: "IntexSpa/Error Number"
    unit_of_measurement: 'E'
  - unique_id: intex_pool_actual_temperature
    device:
      identifiers:
        - "Intex Spa"
      manufacturer: "Intex"
      model: "SPA"
      name: "Intex Spa Pool"
    name: "Intex Pool Actual Temperature"
    state_topic: "IntexSpa/Actual Temperature"
    unit_of_measurement: '°c'
  - unique_id: intex_pool_set_temperature
    device:
      identifiers:
        - "Intex Spa"
      manufacturer: "Intex"
      model: "SPA"
      name: "Intex Spa Pool"
    name: "Intex Pool Set Temperature"
    state_topic: "IntexSpa/Temperature Setpoint"
    unit_of_measurement: '°c'
  - unique_id: intex_pool_heater_status
    device:
      identifiers:
        - "Intex Spa"
      manufacturer: "Intex"
      model: "SPA"
      name: "Intex Spa Pool"
    name: "Intex Pool Heater Status"
    state_topic: "IntexSpa/heater state"
    value_template: >
      {% if value|float == 0 %}
        off
      {% elif value|float == 1 %}
        standby
      {% elif value|float == 2 %}
        on
      {% endif %}

  # Intex Pool Binärsensoren
  binary_sensor:
    - unique_id: intex_pool_pumpenkommunikation
      device:
        identifiers:
          - "Intex Spa"
        manufacturer: "Intex"
        model: "SPA"
        name: "Intex Spa Pool"
      name: "Intex Pool Pumpenkommunikation"
      state_topic: "IntexSpa/Communication with pump"
      payload_on: "1"
      payload_off: "0"
      device_class: connectivity
`

Portos1327, 2023-06-14:
hi rommess, thank you very much for your work I will look at what it looks like in Ha

Thread 47 (2022-05-10):

Device disconnects from MQTT every 30s

guevara777, 2022-05-10:
My device worked good for quite a while. Now it´s not working any more....kind of.

After i upgraded the Home Assistant Mosquitto MQTT Broker Addon to Version 6.1.1 the device keeps losing its connection to MQTT every 30s and reconnects 27s later. After reconnect it loses its connection exactly 30s later.

The Home Assinst Mosquitto Broker Logs just say

```
1652192128: New client connected from 192.168.178.55:54639 as IntexSpa (p2, c1, k15, u'mqtt').
...
1652192143: Client IntexSpa closed its connection.
...
1652192248: New connection from 192.168.178.55:54644 on port 1883.
1652192248: New client connected from 192.168.178.55:54644 as IntexSpa (p2, c1, k15, u'mqtt').
...
1652192263: Client IntexSpa closed its connection.
```

from the serial monitor in arduino ide i get the following debug data

```
15:49:31.038 -> [  3517][D][WiFiGeneric.cpp:852] _eventCallback(): Arduino Event: 0 - WIFI_READY
15:49:31.038 -> [  3520][D][WiFiGeneric.cpp:852] _eventCallback(): Arduino Event: 2 - STA_START
15:49:31.083 ->
15:49:31.083 -> WiFi: Connecting to WLAN_Niehues ... (3.530000s)
15:49:31.083 -> [  3560][D][WiFiGeneric.cpp:852] _eventCallback(): Arduino Event: 5 - STA_DISCONNECTED
15:49:31.083 -> [  3561][W][WiFiGeneric.cpp:873] _eventCallback(): Reason: 202 - AUTH_FAIL
15:49:31.130 -> [  3564][D][WiFiGeneric.cpp:889] _eventCallback(): WiFi Reconnect Running
15:49:31.177 -> [  3660][D][WiFiGeneric.cpp:852] _eventCallback(): Arduino Event: 4 - STA_CONNECTED
15:49:31.224 -> [  3692][D][WiFiGeneric.cpp:852] _eventCallback(): Arduino Event: 7 - STA_GOT_IP
15:49:31.224 -> [  3692][D][WiFiGeneric.cpp:914] _eventCallback(): STA IP: 192.168.178.55, MASK: 255.255.255.0, GW: 192.168.178.1
15:49:31.224 -> WiFi: Connected (3.698000s), ip : 192.168.178.55
15:49:31.744 -> MQTT: Connecting to broker "192.168.178.118" with client name "IntexSpa" and username "mqtt" ... (4.209000s) - ok. (4.499000s)
15:49:32.026 -> MQTT: Subscribed to [IntexSpa/Cmd Power on off]
15:49:32.026 -> MQTT: Subscribed to [IntexSpa/Cmd water filter time]
15:49:32.026 -> MQTT: Subscribed to [IntexSpa/Cmd water filter on off]
15:49:32.026 -> MQTT: Subscribed to [IntexSpa/Cmd bubble on off]
15:49:32.073 -> MQTT: Subscribed to [IntexSpa/Cmd heater on off]
15:49:32.073 -> MQTT: Subscribed to [IntexSpa/Cmd Farenheit Celsius]
15:49:32.073 -> MQTT: Subscribed to [IntexSpa/Cmd decrease]
15:49:32.073 -> MQTT: Subscribed to [IntexSpa/Cmd increase]
15:49:32.073 -> MQTT: Subscribed to [IntexSpa/Cmd Temperature Setpoint]
15:49:32.073 -> MQTT: Subscribed to [IntexSpa/Cmd Reset ESP]
15:49:32.073 -> Debug Pump data : AB 00 00 00 0D 1A 1B 25 00 00 00 00 00 00 00 42 22
15:49:32.073 -> MQTT << [IntexSpa/Power on] 1
15:49:32.073 -> IntexSpa/Power on 1
15:49:32.073 -> MQTT << [IntexSpa/Bubble on] 0
15:49:32.073 -> IntexSpa/Bubble on 0
15:49:32.073 -> MQTT << [IntexSpa/heater on] 1
15:49:32.121 -> IntexSpa/heater on 1
15:49:32.121 -> MQTT << [IntexSpa/heater state] 2

...

15:50:02.140 -> MQTT! Lost connection (34.614000s).
15:50:02.140 -> MQTT: Retrying to connect in 15 seconds.
15:50:17.165 -> MQTT: Connecting to broker "192.168.178.118" with client name "IntexSpa" and username "mqtt" ... (49.614000s)[ 52617][I][WiFiClient.cpp:253] connect(): select returned due to timeout 3000 ms for fd 49
15:50:20.157 -> unable to connect (52.618000s), reason: MQTT_CONNECT_FAILED
15:50:20.157 -> MQTT: Retrying to connect in 15 seconds.
15:50:20.157 -> MQTT!: Failed MQTT connection count: 1
15:50:35.180 -> MQTT: Connecting to broker "192.168.178.118" with client name "IntexSpa" and username "mqtt" ... (67.628000s)[ 70631][I][WiFiClient.cpp:253] connect(): select returned due to timeout 3000 ms for fd 49
15:50:38.154 -> unable to connect (70.632000s), reason: MQTT_CONNECT_FAILED
15:50:38.154 -> MQTT: Retrying to connect in 15 seconds.
15:50:38.201 -> MQTT!: Failed MQTT connection count: 2
15:50:53.154 -> MQTT: Connecting to broker "192.168.178.118" with client name "IntexSpa" and username "mqtt" ... (85.642000s)[ 88644][I][WiFiClient.cpp:253] connect(): select returned due to timeout 3000 ms for fd 49
15:50:56.165 -> unable to connect (88.645000s), reason: MQTT_CONNECT_FAILED
15:50:56.165 -> MQTT: Retrying to connect in 15 seconds.
15:50:56.213 -> MQTT!: Failed MQTT connection count: 3
15:51:11.183 -> MQTT: Connecting to broker "192.168.178.118" with client name "IntexSpa" and username "mqtt" ... (103.655000s)[106658][I][WiFiClient.cpp:253] connect(): select returned due to timeout 3000 ms for fd 49
15:51:14.218 -> unable to connect (106.659000s), reason: MQTT_CONNECT_FAILED
15:51:14.218 -> MQTT: Retrying to connect in 15 seconds.
15:51:14.218 -> MQTT!: Failed MQTT connection count: 4
15:51:29.181 -> MQTT: Connecting to broker "192.168.178.118" with client name "IntexSpa" and username "mqtt" ... (121.669000s) - ok. (121.717000s)
15:51:29.228 -> MQTT: Subscribed to [IntexSpa/Cmd Power on off]
15:51:29.228 -> MQTT: Subscribed to [IntexSpa/Cmd water filter time]
15:51:29.306 -> MQTT: Subscribed to [IntexSpa/Cmd water filter on off]
15:51:29.306 -> MQTT: Subscribed to [IntexSpa/Cmd bubble on off]

...

```

There seems to be a bigger change in that update of mosquitto broker addon. Here is what the Changelog says:

```
6.1.1
Don't purge openssl in cleanup
6.1.0
Update mosquitto to 2.0.11
Remove mosquitto-auth-plug and replace with mosquitto-go-auth 1.8.2
Change base image from Alpine to Debian (required for mosquitto-go-auth)
Note: Mosquitto 2.0.0 did contain some breaking changes. We don't anticipate most users to be affected by them but if you have a heavily customized mosquitto config we would advise reviewing [their changelog](https://mosquitto.org/ChangeLog.txt).
```

I dont know how to solve this problem. Any ideas?

Here is my Sketch from Arduino
[sketch.txt](https://github.com/Yogui79/IntexPureSpa/files/8662464/sketch.txt)

Closed 2022-05-10.

Thread 49 (2022-05-27):

SPA Intex (SB-HWF20)

fnoir, 2022-05-27:
J'ai un SPA Intex modèle SB-HWF20 . De ce que j'ai compris il s'agit d'un modèle de 2021.

Quand j'essaye de faire la recherche du channel, malheureusement la led ne se met pas à clignoter rapidement (juste 1 fois par seconde).
J'ai vérifié le câblage, je me suis rapproché du spa mais rien n'y fait, impossible de récupérer le channel

Channel detection :
```
Le croquis utilise 267998 octets (20%) de l'espace de stockage de programmes. Le maximum est de 1310720 octets.
Les variables globales utilisent 13612 octets (4%) de mémoire dynamique, ce qui laisse 314068 octets pour les variables locales. Le maximum est de 327680 octets.
esptool.py v3.0-dev
Serial port COM12
Connecting........_____....._____....._____....._____.
Chip is ESP32-D0WDQ6 (revision 1)
Features: WiFi, BT, Dual Core, 240MHz, VRef calibration in efuse, Coding Scheme None
Crystal is 40MHz
MAC: c8:c9:a3:d2:da:d0
Uploading stub...
Running stub...
Stub running...
Configuring flash size...
Auto-detected Flash size: 4MB
Compressed 8192 bytes to 47...
Writing at 0x0000e000... (100 %)
Wrote 8192 bytes (47 compressed) at 0x0000e000 in 0.1 seconds (effective 1024.0 kbit/s)...
Hash of data verified.
Compressed 18656 bytes to 12053...
Writing at 0x00001000... (100 %)
Wrote 18656 bytes (12053 compressed) at 0x00001000 in 1.1 seconds (effective 133.4 kbit/s)...
Hash of data verified.
Compressed 268112 bytes to 126046...
Writing at 0x00010000... (12 %)
Writing at 0x00014000... (25 %)
Writing at 0x00018000... (37 %)
Writing at 0x0001c000... (50 %)
Writing at 0x00020000... (62 %)
Writing at 0x00024000... (75 %)
Writing at 0x00028000... (87 %)
Writing at 0x0002c000... (100 %)
Wrote 268112 bytes (126046 compressed) at 0x00010000 in 11.7 seconds (effective 183.2 kbit/s)...
Hash of data verified.
Compressed 3072 bytes to 128...
Writing at 0x00008000... (100 %)
Wrote 3072 bytes (128 compressed) at 0x00008000 in 0.1 seconds (effective 346.1 kbit/s)...
Hash of data verified.

Leaving...
Hard resetting via RTS pin...
```

Sortie console :
```
Channel 0
Channel 1
Channel 2
Channel 3
Channel 4
Channel 5
[...]
Channel FC
Channel FD
Channel FE
Channel FFFFFFFF
Channel 0
Channel 1
```

Je suis disponible pour faire du debug si besoin.

Thread 51 (2022-06-14):

Channel Search

aliessum, 2022-06-14:
### Discussed in https://github.com/Yogui79/IntexPureSpa/discussions/20

<div type='discussions-op-text'>

<sup>Originally posted by **matthias811** July 20, 2021</sup>
First, thanks for providing the manual and code - I hope I will get this working!
Nevertheless I am stuck on Step 1, the channel search. The light is blinking continously and console is showing me all the channel numbers but I cannot detect a flickering like shown in your video. What is the distance the LC12s should be away from the pool? I tried a few meters away. Must there be something activated on the pool or is it just ok to have it on power with pump running?
I have ordered two LC12s by different accounts (to ensure one is there in time) and tried now with both, same effect....</div>

aliessum, 2022-06-14:
First of course many thanks for the effort you have put in the design!
I am facing the same problem as described in #20.
My spa is a Intex type #2845800A, according to the carton box. I have a LC12S V2.03 module (so not the blue one, but red/light brown like on your picture). ESP32 is a devkit C V4, so the one with the extending antenna board.
During channel search the blue led is flashing slow and in the console I can see the numbers counting up. Distance to the pump-unit is less than 1 mtr, but a channel is not detected.
Is there a way that I can check the functionality of the LC12S (perhaps with an oscilloscope, I have one)?
Have you had experiences with bad LC12S modules, should I maybe get another LC12S?
Thanks in advance, Arno.

sjorsdeleede, 2022-07-16:
same problem here...
I tryed it with a Arduino Uno and with a ESP32
From channel 0 till channel FF there is no faster blinking light on any channel
My spa is a 28462 from 2021, i tryed it with the pump running, i also tried with everything turned off and the LC12S was lying on top of the pump

funnyfrish, 2023-03-14:
Any solutions for that problem? How did you fix it?

Thread 56 (2022-07-03):

SearchChannel

MathieuJouslin, 2022-07-03:
Hello,
I have a problem with the channel detection. The led is blinking the same way from channel 0 to FF. I change the delay in the loop function and nothing changed. I try with an arduino Uno, with an ESP32 and 2 different LC12S.
Someone have an idee ?

MathieuJouslin, 2022-07-04:
> Hello, I have a problem with the channel detection. The led is blinking the same way from channel 0 to FF. I change the delay in the loop function and nothing changed. I try with an arduino Uno, with an ESP32 and 2 different LC12S. Someone have an idee ?

Update, it works for me in the dark, the flashing was invisible because of the too bright environment.

dwavrant, 2022-08-07:
Hello @MathieuJouslin

after Channel detection, did you have a quick blink with the correct channel for network id searching ?

Thanks

MathieuJouslin, 2022-08-11:
Hello @dwavrant,
Yes after the channel detection i had a quick blink with the first channel (I had the 33 and 34 so I choose the first one).

Yogui79, 2022-08-13:
Hello
could you please share your code

Thread 62 (2023-03-05):

The 2021 pool seems to use a different communication profile

PLCHome, 2023-03-05:
Hi, to shorten the search for the profile, I connected a TTL serial converter to the pool.

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

### That was the easy part

But the data looks strange:
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

```
00 AA 5A 00 00 AA 2C 00 00 00 04 00 2C 00 00 00 12 00 1C
   1  2  3  4  5  6  7  8  9  10 11 12 13 14 15 16 17 18

Self ID = 0000
NET ID = AA2C
Power = 0 12 dbm
Baud = 04 9600bt
Chanel = 2C
Length = 12

   AA 5A 00 00 AA 2C 00 00 00 04 00 2C 00 00 00 12 00 1C

   01 02 55 AA 03 0E AA BA
   01 02 55 AA 0B 01 0B 00 00 00 00 00 00 00 00 16
   01 02 55 AA 0B 01 0B 00 00 00 00 00 00 00 00 16
   01 02 55 AA 03 0E AA BA
   01 02 55 AA 0B 01 0B 00 00 00 00 00 00 00 00 16
   01 02 55 AA 0B 01 0B 02 02 00 FF FF 00 00 00 18
   01 02 55 AA 0B 01 0B 02 02 00 00 00 00 00 00 1A
   01 02 55 AA 0B 01 0B 02 02 00 00 00 00 00 00 1A
   01 02 55 AA 02 0C 0D
   01 02 55 AA 0B 01 0B 02 02 00 00 00 00 00 00 1A
```

If I take the ESP I get the same data:
```
01 02 55 AA 03 0E AA BA
01 02 55 AA 0B 01 0B 02 02 00 00 03 00 00 00 1D
01 02 55 AA 0B 01 0B 02 02 00 00 03 00 00 00 1D
01 02 55 AA 03 0E AA BA
01 02 55 AA 0B 01 0B 02 02 00 00 03 00 00 00 1D
01 02 55 AA 03 0E AA BA
01 02 55 AA 0B 01 0B 02 02 00 00 03 00 00 00 1D
01 02 55 AA 03 0E AA BA Debug Send command : 2C 00 00 00 00 00 3E EB
01 02 55 AA 0B 01 0B 02 02 00 00 03 00 00 00 1D
01 02 55 AA 03 0E AA BA 01 0B 01 0B 02 02 00 00 03 00 00 00 1D
01 02 55 AA 03 0E AA BA
01 02 55 AA 0B 01 0B 02 02 00 00 03 00 00 00 1D
01 02 55 AA 0B 01 0B 02 02 00 00 03 00 00 00 1D
01 02 55 AA 03 0E AA BA Debug Send command : 2C 00 00 00 00 00 3E EB
01 02 55 AA 0B 01 0B 02 02 00 00 03 00 00 00 1D
01 02 55 AA 03 0E AA BA
01 02 55 AA 0B 01 0B 02 02 00 00 03 00 00 00 1D
01 02 55 AA 03 0E AA BA
01 02 55 AA 0B 01 0B 02 02 00 00 03 00 00 00 1D
01 02 55 AA 0B 01 0B 02 02 00 00 03 00 00 00 1D
01 02 55 AA 03 0E AA BA
01 02 55 AA 0B 01 0B 02 02 00 00 03 00 00 00 1D
01 02 55 AA 03 0E AA BA
01 02 55 AA 0B 01 0B 02 02 00 00 03 00 00 00 1D
01 02 55 AA 0B 01 0B 02 02 00 00 03 00 00 00 1D
01 02 55 AA 03 0E AA BA
01 02 55 AA 0B 01 0B 02 02 00 00 03 00 00 00 1D
01 02 55 AA 03 0E AA BA
01 02 55 AA 0B 01 0B 02 02 00 00 03 00 00 00 1D
01 02 55 AA 03 0E AA BA
01 02 55 AA 0B 01 0B 02 02 00 00 03 00 00 00 1D
01 02 55 AA 0B 01 0B 02 02 00 00 03 00 00 00 1D
01 02 55 AA 03 0E AA BA
01 02 55 AA 0B 01 0B 02 02 00 00 03 00 00 00 1D
01 02 55 AA 03 0E AA BA
01 02 55 AA 0B 01 0B 02 02 00 00 03 00 00 00 1D
01 02 55 AA 03 0E AA BA
01 02 55 AA 0B 01 0B 02 02 00 00 03 00 00 00 1D
01 02 55 AA 0B 01 0B 02 02 00 00 03 00 00 00 1D
01 02 55 AA 03 0E AA BA
01 02 55 AA 0B 01 0B 02 02 00 00 03 00 00 00 1D
01 02 55 AA 03 0E AA BA
01 02 55 AA 0B 01 0B 02 02 00 00 03 00 00 00 1D
01 02 55 AA 0B 01 0B 02 02 00 00 03 00 00 00 1D
01 02 55 AA 03 0E AA BA
01 02 55 AA 0B 01 0B 02 02 00 00 03 00 00 00 1D
01 02 55 AA 03 0E AA BA
01 02 55 AA 0B 01 0B 02 02 00 00 03 00 00 00 1D
01 02 55 AA 03 0E AA BA
01 02 55 AA 0B 01 0B 02 02 00 00 03 00 00 00 1D
01 02 55 AA 0B 01 0B 02 02 00 00 03 00 00 00 1D
01 02 55 AA 03 0E AA BA
01 02 55 AA 0B 01 0B 02 02 00 00 03 00 00 00 1D
01 02 55 AA 03 0E AA BA
01 02 55 AA 0B 01 0B 02 02 00 00 03 00 00 00 1D
01 02 55 AA 0B 01 0B 02 02 00 00 03 00 00 00 1D
01 02 55 AA 03 0E AA BA
01 02 55 AA 0B 01 0B 02 02 00 00 03 00 00 00 1D
01 02 55 AA 03 0E AA BA
01 02 55 AA 0B 01 0B 02 02 00 00 03 00 00 00 1D
01 02 55 AA 03 0E AA BA
```

That seems to be the length.
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

But I guess with the pool everything starts from scratch. They have changed the protocol with the Internet.

Do you have any idea?

Yogui79, 2023-03-06:
Hallo,

honestly I don't know if they changed the protocol, but in vaccording the trace you do louks like.
you seem to have the skills to trace l this, do you have any programming competences?
I will check your trace more detaillaed during the week and will try to provide you a small test programm to be able to check all information

could you just give me the pool model you have ?

coud ytou please poste the code you use for the trace ?

PLCHome, 2023-03-06:
It's an 28462 from 2021.
The trace is from spa.ino. I only changed the debug switches and then wrapped them in the text program at 01 02 55 AA.
I increse the timeout time too.

My C has some rust on it.
Last summer I had adjusted the code for reading via Wifi for the ioBroker.
But the wifi protocol is really bad. Far too slow and cumbersome.

I was hoping this one would work better.
So second mistake, first sold the old one because I thought it would work better with Wifi (OK the old one was too small too) then I have determined that Wifi sucks. And now this doesn't work anymore either.
That's luck...

Yogui79, 2023-03-06:
I think it's possible to also read the information from your spa
If you want I can also provide a code for Arduino mega and and a w5100 ethernet shield

Yogui79, 2023-03-06:
could you please provide log with followind #define configuration

`#define DEBUG_RECIEVED_DATA
//#define DEBUG_SEARCH_CHANNEL
//#define DEBUG_SEND_COMMAND
//#define DEBUG_PUMP_DATA
//#define DEBUG_CONTROLLER_DATA
//#define DEBUG_CONFIG
//#define DEBUG_MQTT
//#define DEBUG_SEND_VALUE_TO_HOME_AUTOMATION_SW`

Thread 66 (2023-04-27):

Configuration.yaml issues

madhehler, 2023-04-27:
Please can you help me.

I have done now everything and finally I am so close but not able in integrate this to Homeassist
From the Putty it seems that the communication is all ok. But how can I get this now into HA?

I copied the YAML from the link here, but what now?
How to get the entities showing up?

PLEASE help
Greetinsg
Mat

 Intex Purespa communication sketch version 1.1.1 build on : 2021.07.31                                                                                 21:27:53

--------------------------------------------------------------------------------                                                                                --------------------------------------
Booting
Ready
IP address: 192.168.178.56
Used Channel read from EEPROM 0x1B
Used first command read from EEPROM 0x9B

WiFi: Connecting to Hehleralive2G ... (3.554000s)
                                                  WiFi: Connected (3.675000s), ip : 192.168.178.56
                                                                                                   MQTT: Connecting to broker "192.168.178.23" with client name (4.175000s) - ok. (4.287000s)
                              MQTT: Subscribed to [IntexSpa/Cmd Power on off]
                                                                             MQTT: Subscribed to [IntexSpa/Cmd water filter time]
                                                                                                                                 MQTT: Subscribed to [IntexSpa/C
                                                                                                                                                                ed to [IntexSpa/Cmd bubble on off]
                                  MQTT: Subscribed to [IntexSpa/Cmd heater on off]
                                                                                  MQTT: Subscribed to [IntexSpa/Cmd Farenheit Celsius]
                                                                                                                                      MQTT: Subscribed to [Intex
                                                                                                                                                                [IntexSpa/Cmd increase]
                       MQTT: Subscribed to [IntexSpa/Cmd Temperature Setpoint]
                                                                              MQTT: Subscribed to [IntexSpa/Cmd Reset ESP]
                                                                                                                          Debug Pump data : 9B 00 00 00 0D 1B 1C
MQTT << [IntexSpa/Power on] 1
                             MQTT << [IntexSpa/Bubble on] 0
                                                           MQTT << [IntexSpa/heater on] 1
                                                                                         MQTT << [IntexSpa/heater state] 2
                                                                                                                          MQTT << [IntexSpa/filter on] 1
                                                                                                                                                        MQTT <<
                                                                                                                                                                 [IntexSpa/Farenheit Celsius] 0
                               MQTT << [IntexSpa/Temperature Setpoint] 27
                                                                         MQTT << [IntexSpa/Cmd Temperature Setpoint] 27
                                                                                                                       MQTT << [IntexSpa/Actual Temperature] 27
                                                                                                                                                               M
                                                                                                                                                                << [IntexSpa/Communication with pump] 1
                                       Debug Pump data : 9B 00 00 00 0D 1B 1C 1B 00 00 00 00 00 00 00 97 9F
Debug Pump data : 9B 00 00 00 0D 1B 1C 1B 00 00 00 00 00 00 00 97 9F
Debug Pump data : 9B 00 00 00 0D 1B 1C 1B 00 00 00 00 00 00 00 97 9F
Debug Pump data : 9B 00 00 00 0D 1B 1C 1B 00 00 00 00 00 00 00 97 9F
Debug Pump data : 9B 00 00 00 0D 1B 1C 1B 00 00 00 00 00 00 00 97 9F
Debug Pump data : 9B 00 00 00 0D 1B 1C 1B 00 00 00 00 00 00 00 97 9F
Debug Pump data : 9B 00 00 00 0D 1B 1C 1B 00 00 00 00 00 00 00 97 9F
Debug Pump data : 9B 00 00 00 0D 1B 1C 1B 00 00 00 00 00 00 00 97 9F
Debug Send command : 9B 00 00 00 00 00 0D 06
Debug Pump data : 9B 00 00 00 0D 1B 1C 1B 00 00 00 00 00 00 00 97 9F
Debug Pump data : 9B 00 00 00 0D 1B 1C 1B 00 00 00 00 00 00 00 97 9F
Debug Pump data : 9B 00 00 00 0D 1B 1C 1B 00 00 00 00 00 00 00 97 9F
Debug Pump data : 9B 00 00 00 0D 1B 1C 1B 00 00 00 00 00 00 00 97 9F
Debug Pump data : 9B 00 00 00 0D 1B 1C 1B 00 00 00 00 00 00 00 97 9F
Debug Pump data : 9B 00 00 00 0D 1B 1C 1B 00 00 00 00 00 00 00 97 9F
Debug Pump data : 9B 00 00 00 0D 1B 1C 1B 00 00 00 00 00 00 00 97 9F
Debug Pump data : 9B 00 00 00 0D 1B 1C 1B 00 00 00 00 00 00 00 97 9F
Debug Pump data : 9B 00 00 00 0D 1B 1C 1B 00 00 00 00 00 00 00 97 9F
Debug Send command : 9B 00 00 00 00 00 0D 06
Debug Pump data : 9B 00 00 00 0D 1B 1C 1B 00 00 00 00 00 00 00 97 9F
Debug Pump data : 9B 00 00 00 0D 1B 1C 1B 00 00 00 00 00 00 00 97 9F
Debug Pump data : 9B 00 00 00 0D 1B 1C 1B 00 00 00 00 00 00 00 97 9F
Debug Pump data : 9B 00 00 00 0D 1B 1C 1B 00 00 00 00 00 00 00 97 9F
Debug Pump data : 9B 00 00 00 0D 1B 1C 1B 00 00 00 00 00 00 00 97 9F
Debug Pump data : 9B 00 00 00 0D 1B 1C 1B 00 00 00 00 00 00 00 97 9F
Debug Send command : 9B 00 00 00 00 00 0D 06
Debug Pump data : 9B 00 00 00 0D 1B 1C 1B 00 00 00 00 00 00 00 97 9F
Debug Pump data : 9B 00 00 00 0D 1B 1C 1B 00 00 00 00 00 00 00 97 9F
Debug Pump data : 9B 00 00 00 0D 1B 1C 1B 00 00 00 00 00 00 00 97 9F
Debug Pump data : 9B 00 00 00 0D 1B 1C 1B 00 00 00 00 00 00 00 97 9F
Debug Pump data : 9B 00 00 00 0D 1B 1C 1B 00 00 00 00 00 00 00 97 9F
Debug Pump data : 9B 00 00 00 0D 1B 1C 1B 00 00 00 00 00 00 00 97 9F
Debug Pump data : 9B 00 00 00 0D 1B 1C 1B 00 00 00 00 00 00 00 97 9F
Debug Pump data : 9B 00 00 00 0D 1B 1C 1B 00 00 00 00 00 00 00 97 9F
Debug Send command : 9B 00 00 00 00 00 0D 06
Debug Pump data : 9B 00 00 00 0D 1B 1C 1B 00 00 00 00 00 00 00 97 9F
Debug Pump data : 9B 00 00 00 0D 1B 1C 1B 00 00 00 00 00 00 00 97 9F

Thread 73 (2024-06-08):

Channel/Network search with ESP32 not working

Tinyhellboy, 2024-06-08:
First off all thank you for all the work that all of you guys already put in this project.

I bought a 2021 Model, all of the components and downloaded the software. When I run the Channel search with my Arduino plugged to the LC12, I get the response on Channel 15 also the Network search is performs flawlessly. As soon as I connect the LC12 to the ESP32(AZ-Delivery Dev Kit V4), neither the Channel search nor the Network search is working. Only blinking LC12
CP210XVCP Driver is downloaded, Pin connection was checked many times, no success.
The only thing that is different to your description is, that I can't use "AVR" as Programer in the Arduino IDE (1.8.x and also 2.3.2) I can only select "Eptool" there.

Anyone an idea or do I miss something? Can I use a different ESP32?

Thank you in advance

jmhberry, 2024-06-18:
Great project !

I tried a lot of time but I did'nt found The channel. Only blink on the blue led, no response (using ESP32 kit C, and esp Driver V2, version 3.01 output no serial2 signal)
An Idéa ?

Thread 75 (2024-09-07):

cannot compile the code

numerobis08, 2024-09-07:
in the past i used successfully the code and now i do have the following error message when i try to compile the code
/Users/PO/Documents/Arduino/libraries/EspMQTTClient/src/EspMQTTClient.cpp: In member function 'void EspMQTTClient::loop()':
/Users/PO/Documents/Arduino/libraries/EspMQTTClient/src/EspMQTTClient.cpp:272:13: error: 'class EspClass' has no member named 'reset'
         ESP.reset();
             ^
Plusieurs bibliothèque trouvées pour "WiFiClient.h"
Utilisé : /Users/PO/Library/Arduino15/packages/esp32/hardware/esp32/1.0.6/libraries/WiFi
Non utilisé : /private/var/folders/vt/_1qh_xdx62xcwllq01svtgv40000gn/T/AppTranslocation/CE0ACCA5-2323-45C8-BFF6-EFDF78648E85/d/Arduino.app/Contents/Java/libraries/WiFi
Non utilisé : /Users/PO/Documents/Arduino/libraries/WiFi
exit status 1
Erreur de compilation pour la carte ESP32 Wrover Module

Thread 78 (2025-05-21):

No channel detection - version of LC12s compatibility ?

courtoiss, 2025-05-21:
Hello
I've got a spa SC20 and i try to connect it form an esp32 + LC12s as you do.

I can't detect the channel. The led is blinking normaly, but no detection as you show in your video.
I've read many of the messages posted here, and double check my connections. I think i'm good.
I've tried near and far, with pump on and off, etc...
I've also tried the modified scripts by @fsedarkalex , without luck.

Do you have some advice ? Can i check some logs to be sure my connections are good ?

Moreover, I have seein in the recent messages that people have the same problem. Do you think it's possible that is the LC12s current version wich is not compatible ? I have recived the LC12s v2.09

I read on
https://fr.aliexpress.com/item/32823346122.html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
that some models can be not compatible.

Do you know if i must buy another LC12s card ? wich version minimum - maximum ? What is YOUR version ?
Do you know some vendor that have old version to sell ?

Maybe i'm confusing. If you have some other advice, thank you.
Best regards
Sylvain (France)

alexh-fr, 2025-06-04:
> PS: i'm now waiting for the NetworkID, I cross the fingers.

Looking forward to reading your results!
I also bought an "older" model of LC12S on Aliexpress, but the package arrived empty...

I'm working around my need by resuming development of an alternative to control my spa using Python (but the spa must be connected to the Wi-Fi network).

fsedarkalex, 2025-06-29:
Ich glaube die WLAN Variante hatte ein anderes Kommunikationsmodul. Ich bin nicht 100% sicher aber ich glaube die ist nicht kompatibel Sent from NineVon: ghost7203 ***@***.***>Gesendet: Sonntag, 29. Juni 2025 05:50An: Yogui79/IntexPureSpaCc: fsedarkalex; MentionBetreff: Re: [Yogui79/IntexPureSpa] No channel detection - version of LC12s compatibility ? (Issue #78) ghost7203 left a comment (Yogui79/IntexPureSpa#78)

Hallo Alles ist in Ordnung, es funktioniert! Vielen Dank für die Arbeit und die Dokumentation. Ich habe alle Zustände in meinem Jeedom enthalten und Befehle erstellt, um die Aktionen zu starten. Ich denke, Sie müssen sich entscheiden, ob Sie sich mit dem lc12s oder über WLAN verbinden möchten. Das hängt von der Art des Spas ab. Ein Spa kann nicht beides.

Ich habe auch das Thema das ich weder Channel noch netzwerk id richtig finde. mein Spa ist mit dem wlan und der App verbunden muss ich das zuerst trennen bevor ich scanne ? Wäre über Hilfe unendlich dankbar. ich habe einen Intex pur spa 28442-018 /20210423 JPA20

—Reply to this email directly, view it on GitHub, or unsubscribe.You are receiving this because you were mentioned.Message ID: ***@***.***>

[
{
***@***.***": "http://schema.org",
***@***.***": "EmailMessage",
"potentialAction": {
***@***.***": "ViewAction",
"target": "https://github.com/Yogui79/IntexPureSpa/issues/78#issuecomment-3016273043",
"url": "https://github.com/Yogui79/IntexPureSpa/issues/78#issuecomment-3016273043",
"name": "View Issue"
},
"description": "View this Issue on GitHub",
"publisher": {
***@***.***": "Organization",
"name": "GitHub",
"url": "https://github.com"
}
}
]

ghost7203, 2025-06-30:
Hallo Fsedarkalex,
Nach dem ich ausgiebig getestet habe mit dem Channel hab ich ein ganz schwaches blinken auf Kanal 59 am LC12 endteckt, also glaube ich das ich schon einen LC12 in der Poolsteuerung verbaut habe, es ist wirklich ein ganz ganz schwaches blinken fast nicht sichtbar. Was meinst du als Experte dazu? jetzt versuche ich die Netzwerk ID rauszufinden, wie sollte das aussehen wenn ich mitloge via Putty, kannst du mir da so ein Besispiel bild senden.
Vielen lieben Dank und Grüße aus Vienna Robert

fsedarkalex, 2025-06-30:
Du siehst an der Konsole nichts davon, weil die network id nicht stimmt.Aber das minimale Blinken ist richtig. MN sieht es nur schwer.Sent from NineVon: ghost7203 ***@***.***>Gesendet: Montag, 30. Juni 2025 06:31An: Yogui79/IntexPureSpaCc: fsedarkalex; MentionBetreff: Re: [Yogui79/IntexPureSpa] No channel detection - version of LC12s compatibility ? (Issue #78) ghost7203 left a comment (Yogui79/IntexPureSpa#78)
Hallo Fsedarkalex,
Nach dem ich ausgiebig getestet habe mit dem Channel hab ich ein ganz schwaches blinken auf Kanal 59 am LC12 endteckt, also glaube ich das ich schon einen LC12 in der Poolsteuerung verbaut habe, es ist wirklich ein ganz ganz schwaches blinken fast nicht sichtbar. Was meinst du als Experte dazu? jetzt versuche ich die Netzwerk ID rauszufinden, wie sollte das aussehen wenn ich mitloge via Putty, kannst du mir da so ein Besispiel bild senden.
Vielen lieben Dank und Grüße aus Vienna Robert

—Reply to this email directly, view it on GitHub, or unsubscribe.You are receiving this because you were mentioned.Message ID: ***@***.***>

[
{
***@***.***": "http://schema.org",
***@***.***": "EmailMessage",
"potentialAction": {
***@***.***": "ViewAction",
"target": "https://github.com/Yogui79/IntexPureSpa/issues/78#issuecomment-3017745369",
"url": "https://github.com/Yogui79/IntexPureSpa/issues/78#issuecomment-3017745369",
"name": "View Issue"
},
"description": "View this Issue on GitHub",
"publisher": {
***@***.***": "Organization",
"name": "GitHub",
"url": "https://github.com"
}
}
]

ghost7203, 2025-06-30:
Ich meinte wenn ich die Netzwerk ID im zweiten schritt mache und diese Aufzeichne kommen pr scan im Log 2 Einträge
config AA 00 .. .. ... ...
AA  00  ..  .. ..
Wie sollte es ausehen wenn er die Netzwerk ID  findet (wie ist dann der Eintrag)
Danke
LG Robert
