Yogui79/IntexPureSpa/(commit log)

2021-02-17 ScreenshotOTA & Board IDE
2021-02-26 change timer function to most common arduino ide timer function
2021-03-12 add temperature setpoint as value
2021-04-18 README.md - Update: heat status
2021-04-18 add topic for heter temperature and fix state heater on if heater in standby
    [Spa.ino]
2021-04-18 fix copy paste error on topic heater state
    [Spa.ino]
2021-04-19 Revert "fix copy paste error on topic heater state"
    This reverts commit a9dbe0c6d2b77f7785ef16dc3348c21c60158ba7.
    [Spa.ino]
2021-04-19 Revert "Revert "fix copy paste error on topic heater state""
    This reverts commit a219c88afe3d11a2bddf09eb3fc2533a0e93af0e.
    [Spa.ino]
2021-04-30 Fix temperature + - command modify some timer value add temperature limitation
    [Spa.ino]
2021-05-03 fix network id issue and add some debug info
    [Spa.ino]
2021-05-22 fix issue for the sanitizer and reciriculation
    [Spa.ino]
2021-05-24 add channel switch in case difference between channel and first character is > 0x80 for 28442 and 28440
2021-05-29 fix release date problem increase timeout time
    [Spa.ino]
2021-07-24 Update README.md
    Change information for install Borad, i used 2.0.1-rc1 and wifi not work. V1 board frreeze in booting . Led blink weak
